LED-BOY/PCB-Led-display-wifi-clock/schematic v1.7.png

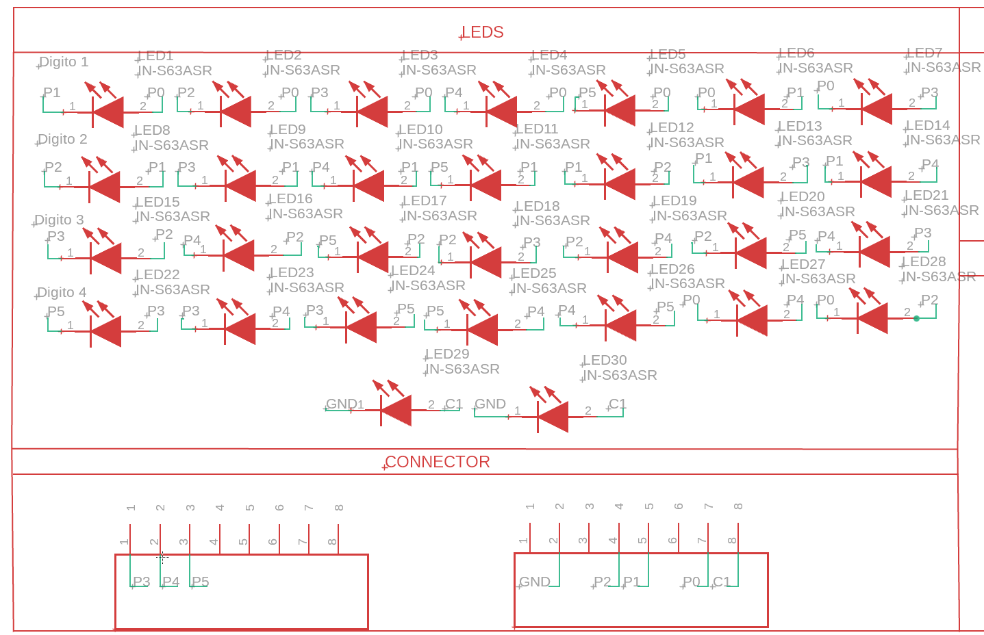
schematic v1.7.png
