LED-BOY/PCB-Led-display-wifi-clock/(commit log)

2026-09-11 Rename Schematic.png to Schematic v1.5.png
2026-10-30 docs: professionalize GemaLight project and organize Arduino sketch
    Add English/Spanish overviews, hardware and firmware guides, setup and
    validation notes, contribution templates and Git housekeeping. Preserve
    firmware bytes while placing the sketch in an Arduino-compatible folder.
2026-11-01 Allow release packaging to attach assets to the published tag
